im-tomu/tomu-hardware/(notices)

Notices in the files:
pcb/tomu.kicad_pcb:
License: CC-BY-SA 4.0 or TAPR
